seismicindustries/IPS2/panel/13_IPS2_usbC_frontpanel.STEP

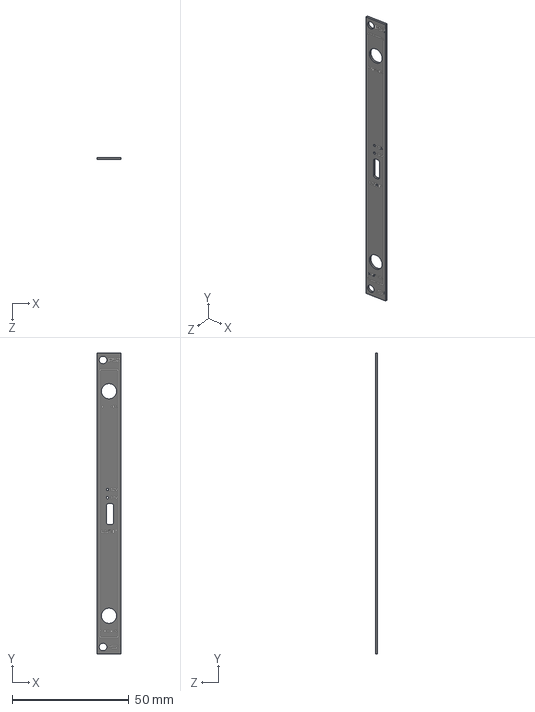
[picture p3: CAD file, 2019-10-16]
panel/13_IPS2_usbC_frontpanel.STEP
10.1 x 128.7 x 1.00 mm
