seismicindustries/IPS2/IPS2.kicad_pcb

## KiCad design IPS2.kicad_pcb (2019-10-16)

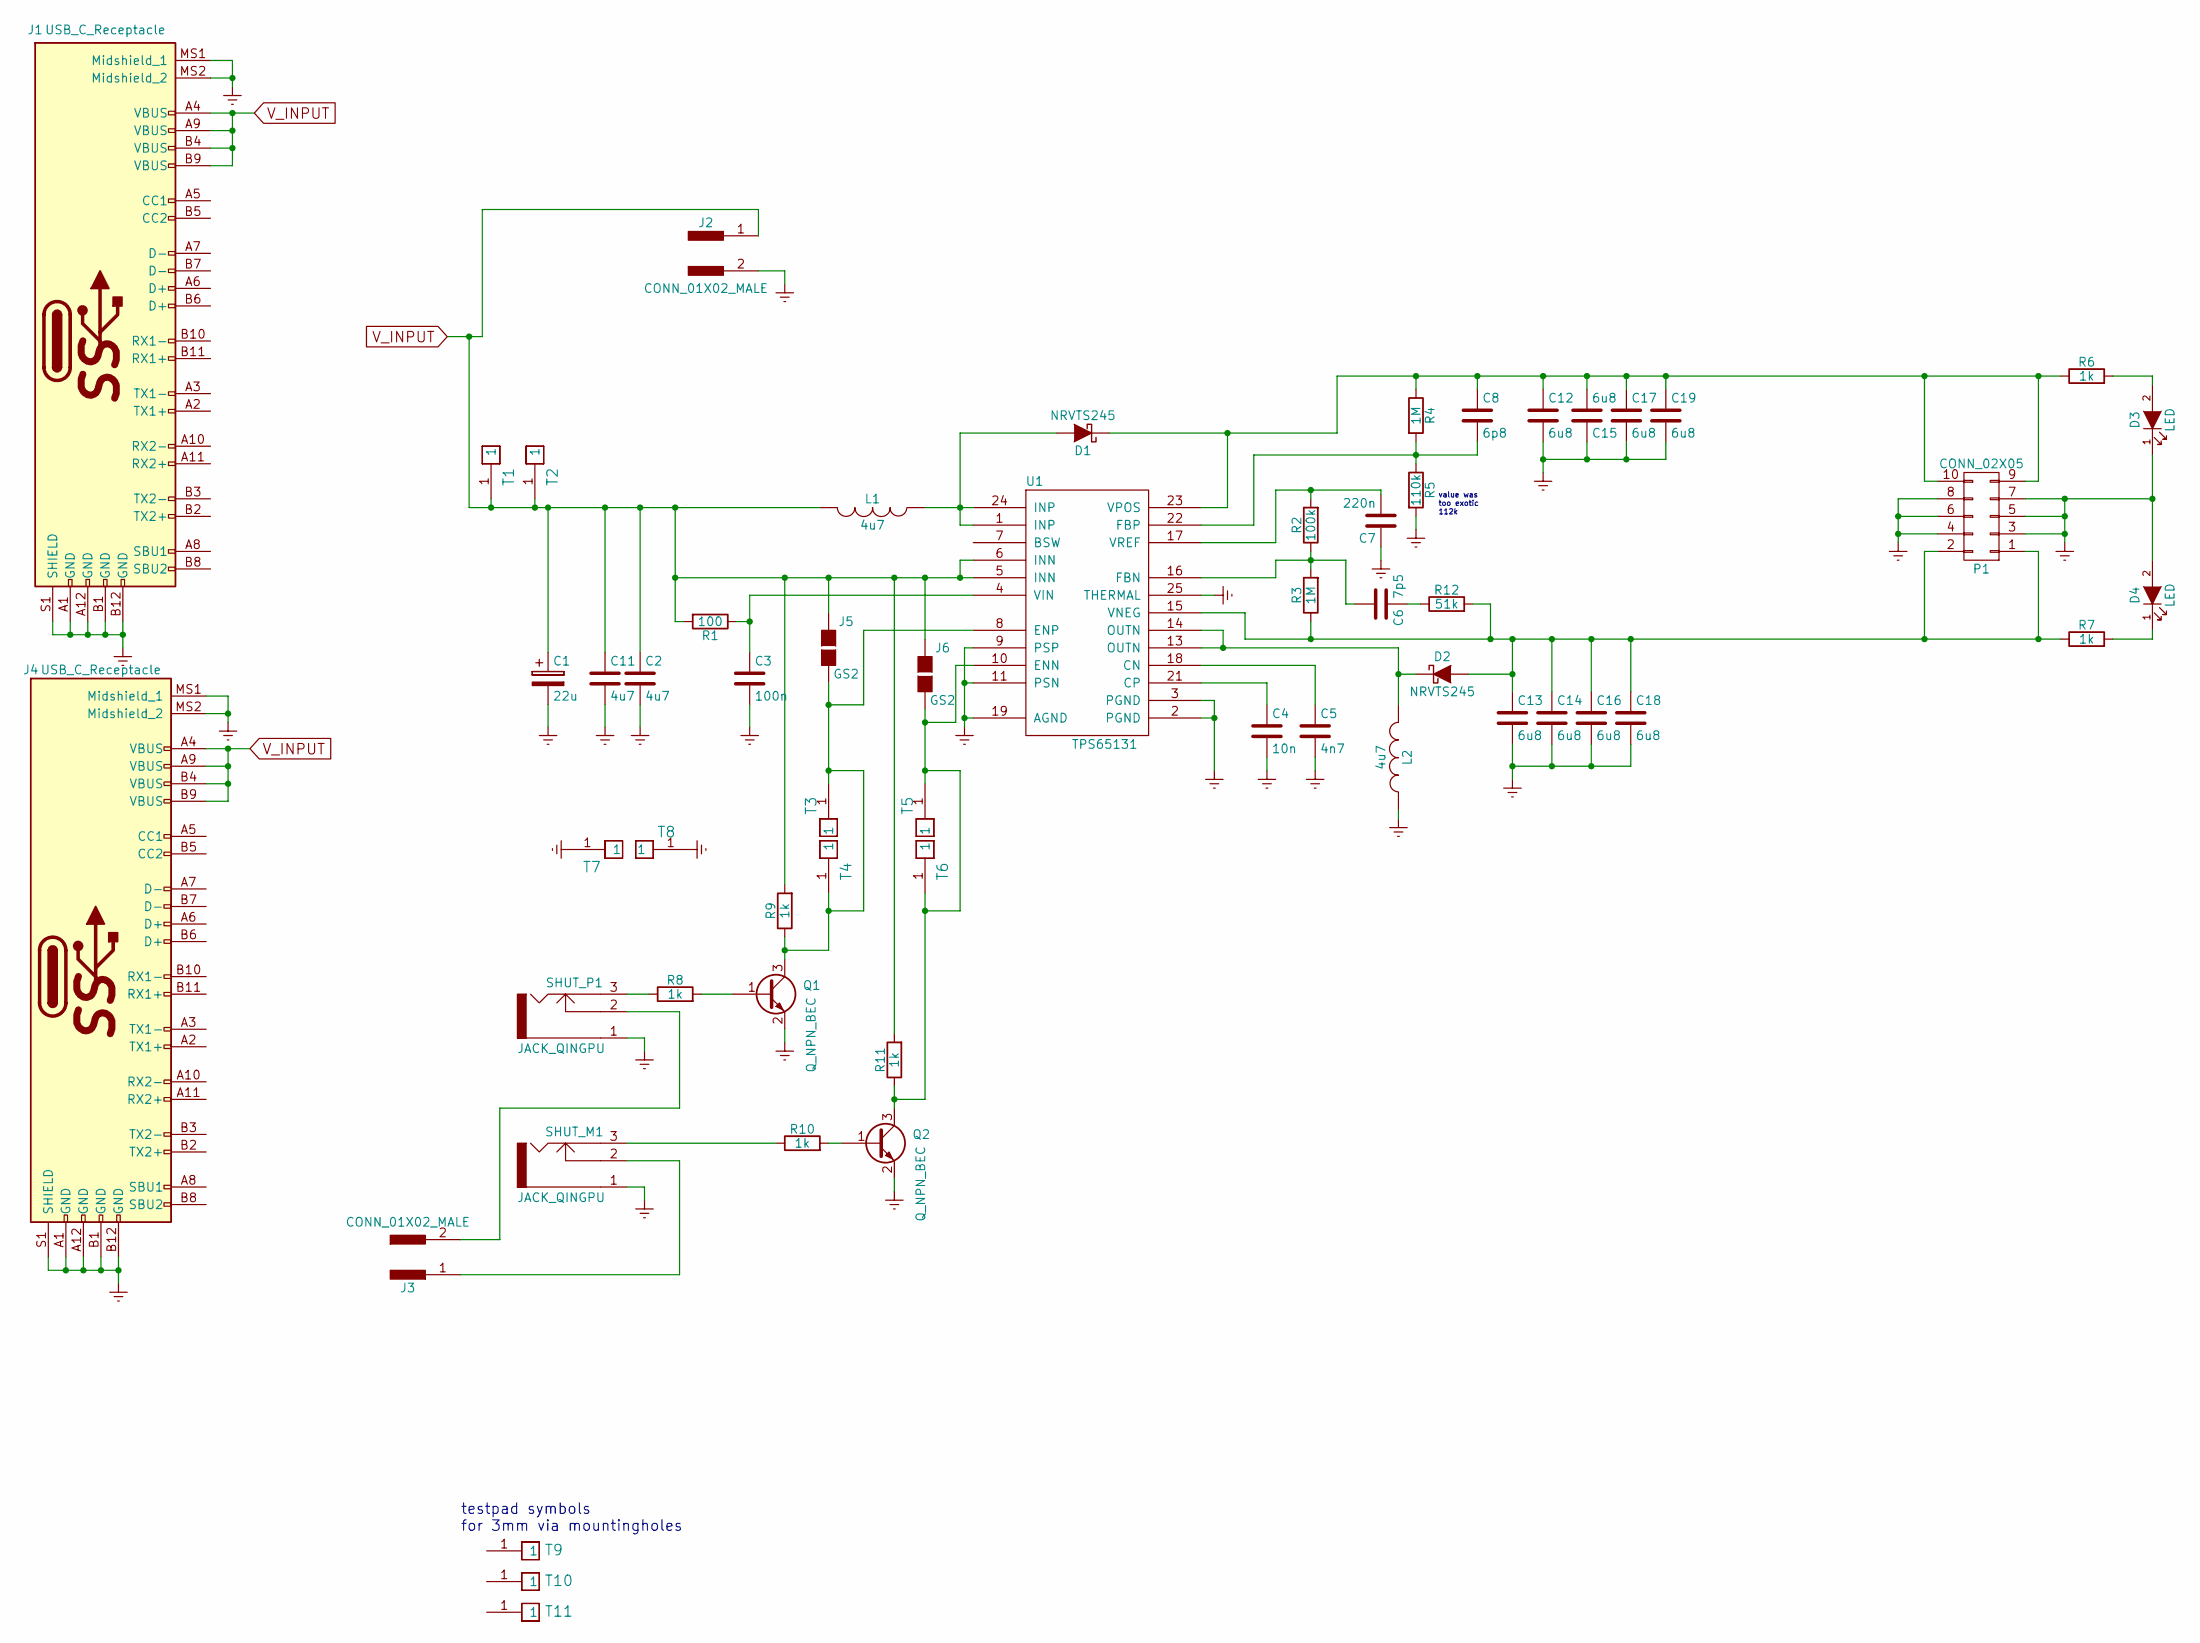
[picture p4: schematic IPS2.sch, IPS2 - Interruptible Power Supply 2]

Parts:
C1: 22u; CP_Elec_7.3x4.3; MPN EEF-CX1D220R
C2, C11: 4u7; C_0805; MPN GRM21BR61H475KE51L
C3: 100n; C_0603; MPN C0603C104Z3VACTU
C4: 10n; C_0603; MPN 885012206065
C5: 4n7; C_0603; MPN 885012206087
C6: 7p5; C_0603; MPN GRM1885C1H7R5BA1D
C7: 220n; C_0603; MPN CC603KRX7R7BB224
C8: 6p8; C_0603; MPN 885012006050
C12, C13, C14, C15, C16, C17, C18, C19: 6u8; C_1206; MPN C3216X7R1E685K160AB
D1, D2: NRVTS245; D_SOD-123F; MPN NRVTS245ESFT3G
D3, D4: LED; C_0805; MPN APT2012SGC
J1, J4: USB_C_Receptacle; USB_TYPE_C_WUERTH_632723300011; MPN 632723300011
J2: CONN_01X02_MALE; Pin_Header_Angled_1x02_Pitch2.54mm
J3: CONN_01X02_MALE; Pin_Header_Angled_2x01_Pitch2.54mm
J5, J6: GS2
L1, L2: 4u7; Inductor_SRN4018TA_bourns; MPN SRN4018TA-4R7M
P1: CONN_02X05; Pin_Header_Angled_2x05_Pitch2.54mm_with_space_for_con; MPN 649-68020-110HLF
Q1, Q2: Q_NPN_BEC; SOT-23; MPN BC847CLT1G
R1: 100; R_0603; MPN CRCW0603100RFKEAC
R2: 100k; R_0603; MPN RCA0603100KJNEC
R3, R4: 1M; R_0603; MPN RC0603FR-071ML
R5: 110k; R_0603; MPN CR0603-FX-1103ELF
R6, R7, R8, R9, R10, R11: 1k; R_0603; MPN RC0603FR-071KL
R12: 51k; R_0603; MPN RC0603FR-0751KL
SHUT_M1: JACK_QINGPU; jack_qingpu
SHUT_P1: JACK_QINGPU; jack_qingpu
T1, T2, T3, T4, T5, T6, T7, T8: TESTPIN; TESTPAD_SMD_and_THT_SQR
T9, T10, T11: TESTPIN; VIA_M3_mounting_hole
U1: TPS65131; QFN-24-4x4mm_Pitch0.5mm_handsolder_big_thermal_hole; MPN TPS65131RGER

Connections:
Earth: C1.2, C2.2, C3.2, C4.2, C5.2, C7.1, C11.2, C12.2, C13.2, C14.2, C15.1, C16.2, C17.2, C18.2, C19.2, D3.1 (K), D4.2 (A), J1.A1 (GND), J1.A12 (GND), J1.B1 (GND), J1.B12 (GND), J1.MS1 (Midshield_1), J1.MS2 (Midshield_2), J1.S1 (SHIELD), J2.2, J4.A1 (GND), J4.A12 (GND), J4.B1 (GND), J4.B12 (GND), J4.MS1 (Midshield_1), J4.MS2 (Midshield_2), J4.S1 (SHIELD), L2.1, P1.3, P1.4, P1.5, P1.6, P1.7, P1.8, Q1.2 (E), Q2.2 (E), R5.2, SHUT_M1.1, SHUT_P1.1, T7.1, T8.1, U1.2 (PGND), U1.3 (PGND), U1.9 (PSP), U1.11 (PSN), U1.19 (AGND), U1.25 (THERMAL)
unnamed: C3.1, R1.1, U1.4 (VIN)
unnamed: C4.1, U1.21 (CP)
unnamed: C5.1, U1.18 (CN)
unnamed: C6.1, R12.1
unnamed: C6.2, R2.1, R3.2, U1.16 (FBN)
unnamed: C7.2, R2.2, U1.17 (VREF)
unnamed: C8.2, R4.2, R5.1, U1.22 (FBP)
unnamed: C8.1, C12.1, C15.2, C17.1, C19.1, D1.1 (K), P1.9, P1.10, R4.1, R6.1, U1.23 (VPOS)
unnamed: C13.1, C14.1, C16.1, C18.1, D2.2 (A), P1.1, P1.2, R3.1, R7.1, R12.2, U1.15 (VNEG)
unnamed: D1.2 (A), L1.1, U1.1 (INP), U1.24 (INP)
unnamed: D2.1 (K), L2.2, U1.13 (OUTN), U1.14 (OUTN)
unnamed: D3.2 (A), R6.2
unnamed: D4.1 (K), R7.2
unnamed: J3.1, SHUT_M1.2
unnamed: J3.2, SHUT_P1.2
unnamed: J5.2 (G2), Q1.3 (C), R9.1, T3.1, T4.1, U1.8 (ENP)
unnamed: J6.2 (G2), Q2.3 (C), R11.1, T5.1, T6.1, U1.10 (ENN)
unnamed: Q1.1 (B), R8.2
unnamed: Q2.1 (B), R10.2
unnamed: R8.1, SHUT_P1.3
unnamed: R10.1, SHUT_M1.3
V_INPUT: C1.1, C2.1, C11.1, J1.A4 (VBUS), J1.A9 (VBUS), J1.B4 (VBUS), J1.B9 (VBUS), J2.1, J4.A4 (VBUS), J4.A9 (VBUS), J4.B4 (VBUS), J4.B9 (VBUS), J5.1 (G1), J6.1 (G1), L1.2, R1.2, R9.2, R11.2, T1.1, T2.1, U1.5 (INN), U1.6 (INN)

Notes on the sheet:
testpad symbols for 3mm via mountingholes
value was too exotic 112k

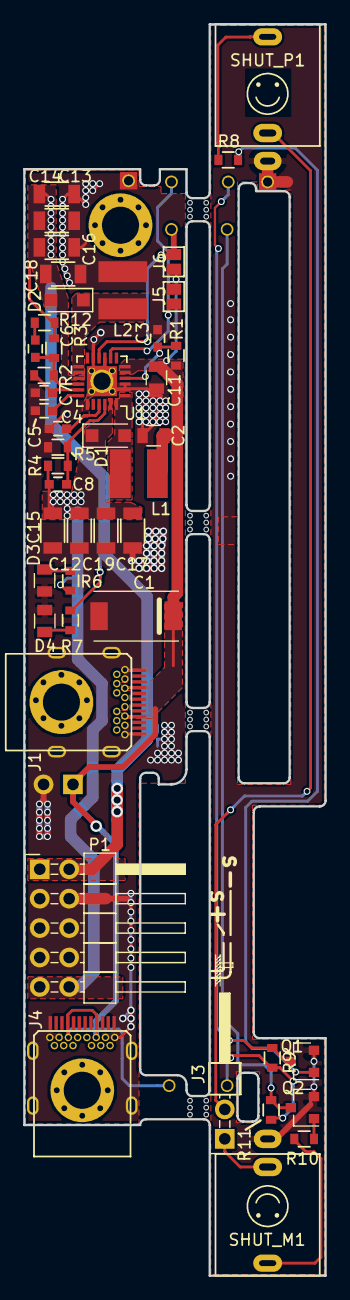
[picture p5: board IPS2.kicad_pcb from above]

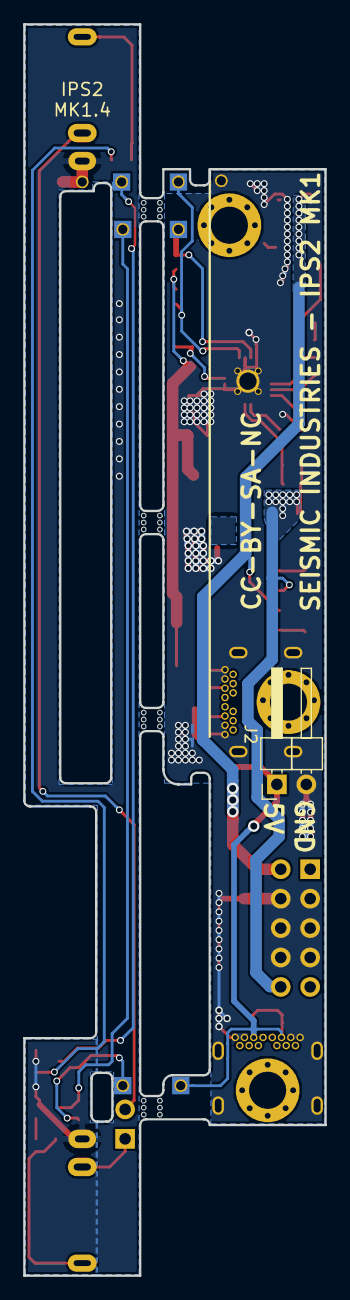
[picture p6: board IPS2.kicad_pcb from below]

Board: 2 copper layers, 26.0 x 108.0 mm, 58 parts (7 on the bottom side), 23 nets.
