seismicindustries/IPS2/(commit log)

2019-10-16 first commit - added all files and pic to the repo
    [IPS2.kicad_pcb, IPS2.sch]
2019-10-16 added panel .step file
    [13_IPS2_usbC_frontpanel.STEP]
2019-11-30 added BOM as csv
    [IPS2_BOM_usb_c.csv]
